sofiapanag/FollowMe-Robot-ESE-519/README.md

# FINAL PROJECT - FOLLOW ME CART GROUP 22

## DEVPOST LINK
https://devpost.com/software/final-project-3opmc1

## Youtube LINK
https://youtu.be/UMGsdQlZP_E

## Compilation
- please find the main.c. Microchip Studio is really bloated hence we placed the whole project in repo. You may need to setup the uart functionalities.
- the controller folder contains necessary files for NodeMCU. You may nead to install the AdaFruit bluefruit library.

### BLUETOOTH

Node MCU - Level Shifter - Arduino

Node MCU SPI Pins
- CLK  - D5
- COPI - D6
- CIPO - D7
- CS   - D8
- IRQ  - D3
- RST  - D2
- Arduino - D1
- Arduino - D0
- Arduino - D4
