sofiapanag/FollowMe-Robot-ESE-519/project_pic.jpeg

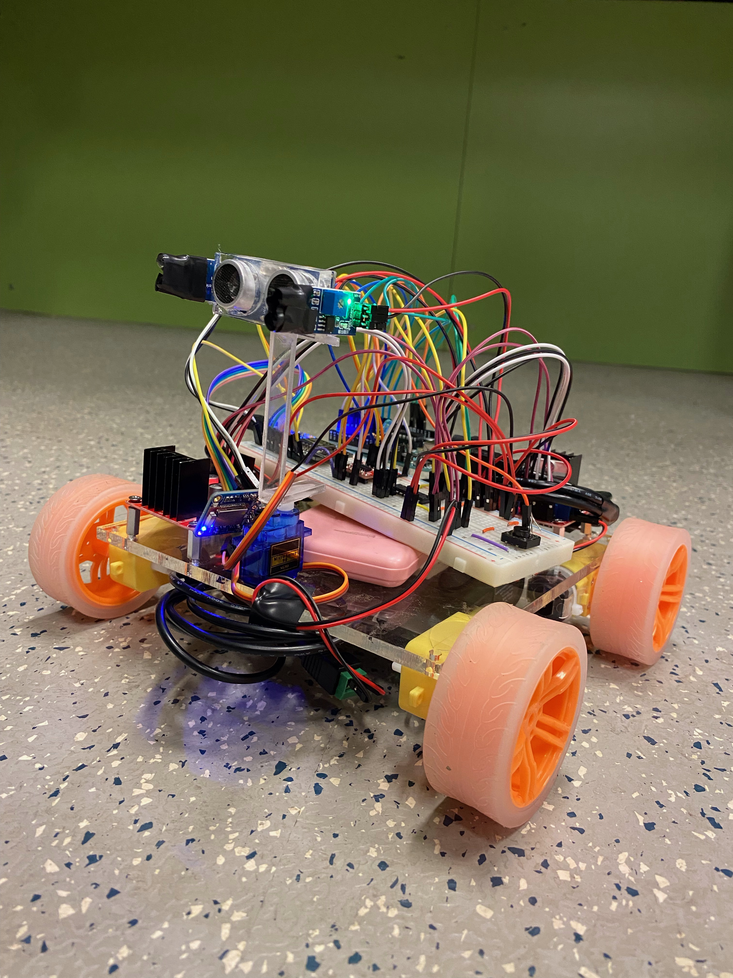
project_pic.jpeg
