sofiapanag/FollowMe-Robot-ESE-519/controller/controller.ino

/*********************************************************************
 This is an example for our nRF51822 based Bluefruit LE modules

 Pick one up today in the adafruit shop!

 Adafruit invests time and resources providing this open source code,
 please support Adafruit and open-source hardware by purchasing
 products from Adafruit!

 MIT license, check LICENSE for more information
 All text above, and the splash screen below must be included in
 any redistribution
*********************************************************************/

#include <string.h>
#include <math.h>
#include <Arduino.h>
#include <SPI.h>
#include "Adafruit_BLE.h"
#include "Adafruit_BluefruitLE_SPI.h"
#include "Adafruit_BluefruitLE_UART.h"

#include "BluefruitConfig.h"


#define UP           1
#define DOWN         3
#define CONNECT         2
// #define RIGHT        4

#if SOFTWARE_SERIAL_AVAILABLE
  #include <SoftwareSerial.h>
#endif

/*=========================================================================
    APPLICATION SETTINGS

    FACTORYRESET_ENABLE       Perform a factory reset when running this sketch
   
                              Enabling this will put your Bluefruit LE module
                              in a 'known good' state and clear any config
                              data set in previous sketches or projects, so
                              running this at least once is a good idea.
   
                              When deploying your project, however, you will
                              want to disable factory reset by setting this
                              value to 0.  If you are making changes to your
                              Bluefruit LE device via AT commands, and those
                              changes aren't persisting across resets, this
                              is the reason why.  Factory reset will erase
                              the non-volatile memory where config data is
                              stored, setting it back to factory default
                              values.
       
                              Some sketches that require you to bond to a
                              central device (HID mouse, keyboard, etc.)
                              won't work at all with this feature enabled
                              since the factory reset will clear all of the
                              bonding data stored on the chip, meaning the
                              central device won't be able to reconnect.
    MINIMUM_FIRMWARE_VERSION  Minimum firmware version to have some new features
    MODE_LED_BEHAVIOUR        LED activity, valid options are
                              "DISABLE" or "MODE" or "BLEUART" or
                              "HWUART"  or "SPI"  or "MANUAL"
    -----------------------------------------------------------------------*/
    #define FACTORYRESET_ENABLE         1
    #define MINIMUM_FIRMWARE_VERSION    "0.6.6"
    #define MODE_LED_BEHAVIOUR          "MODE"
/*=========================================================================*/

// Create the bluefruit object, either software serial...uncomment these lines
/*
SoftwareSerial bluefruitSS = SoftwareSerial(BLUEFRUIT_SWUART_TXD_PIN, BLUEFRUIT_SWUART_RXD_PIN);

Adafruit_BluefruitLE_UART ble(bluefruitSS, BLUEFRUIT_UART_MODE_PIN,
                      BLUEFRUIT_UART_CTS_PIN, BLUEFRUIT_UART_RTS_PIN);
*/

/* ...or hardware serial, which does not need the RTS/CTS pins. Uncomment this line */
// Adafruit_BluefruitLE_UART ble(BLUEFRUIT_HWSERIAL_NAME, BLUEFRUIT_UART_MODE_PIN);

/* ...hardware SPI, using SCK/MOSI/MISO hardware SPI pins and then user selected CS/IRQ/RST */
Adafruit_BluefruitLE_SPI ble(BLUEFRUIT_SPI_CS, BLUEFRUIT_SPI_IRQ, BLUEFRUIT_SPI_RST);

/* ...software SPI, using SCK/MOSI/MISO user-defined SPI pins and then user selected CS/IRQ/RST */
//Adafruit_BluefruitLE_SPI ble(BLUEFRUIT_SPI_SCK, BLUEFRUIT_SPI_MISO,
//                             BLUEFRUIT_SPI_MOSI, BLUEFRUIT_SPI_CS,
//                             BLUEFRUIT_SPI_IRQ, BLUEFRUIT_SPI_RST);


// A small helper
void error(const __FlashStringHelper*err) {
  Serial.println(err);
  while (1);
}

// function prototypes over in packetparser.cpp
uint8_t readPacket(Adafruit_BLE *ble, uint16_t timeout);
float parsefloat(uint8_t *buffer);
void printHex(const uint8_t * data, const uint32_t numBytes);

// the packet buffer
extern uint8_t packetbuffer[];


/**************************************************************************/
/*!
    @brief  Sets up the HW an the BLE module (this function is called
            automatically on startup)
*/
/**************************************************************************/
void setup(void)
{
  while (!Serial);  // required for Flora & Micro
  delay(500);

  Serial.begin(115200);
  Serial.println(F("Adafruit Bluefruit App Controller Example"));
  Serial.println(F("-----------------------------------------"));

  /* Initialise the module */
  Serial.print(F("Initialising the Bluefruit LE module: "));

  if ( !ble.begin(VERBOSE_MODE) )
  {
    error(F("Couldn't find Bluefruit, make sure it's in CoMmanD mode & check wiring?"));
  }
  Serial.println( F("OK!") );

  if ( FACTORYRESET_ENABLE )
  {
    /* Perform a factory reset to make sure everything is in a known state */
    Serial.println(F("Performing a factory reset: "));
    if ( ! ble.factoryReset() ){
      error(F("Couldn't factory reset"));
    }
  }


  /* Disable command echo from Bluefruit */
  ble.echo(false);

  Serial.println("Requesting Bluefruit info:");
  /* Print Bluefruit information */
  ble.info();

  Serial.println(F("Please use Adafruit Bluefruit LE app to connect in Controller mode"));
  Serial.println(F("Then activate/use the sensors, color picker, game controller, etc!"));
  Serial.println();

  ble.verbose(false);  // debug info is a little annoying after this point!

  /* Wait for connection */
  while (! ble.isConnected()) {
      delay(500);
  }

  Serial.println(F("******************************"));

  // LED Activity command is only supported from 0.6.6
  if ( ble.isVersionAtLeast(MINIMUM_FIRMWARE_VERSION) )
  {
    // Change Mode LED Activity
    Serial.println(F("Change LED activity to " MODE_LED_BEHAVIOUR));
    ble.sendCommandCheckOK("AT+HWModeLED=" MODE_LED_BEHAVIOUR);
  }

  // Set Bluefruit to DATA mode
  Serial.println( F("Switching to DATA mode!") );
  ble.setMode(BLUEFRUIT_MODE_DATA);

  Serial.println(F("******************************"));

  digitalWrite(16, HIGH);
  pinMode(16, OUTPUT); // maintain connection
  
  digitalWrite(5, HIGH);
  pinMode(5, OUTPUT); // maintain connection
  
  digitalWrite(2, HIGH);
  pinMode(2, OUTPUT); // maintain connection

}

/**************************************************************************/
/*!
    @brief  Constantly poll for new command or response data
*/
/**************************************************************************/


// float prev_lat, prev_long, prev_alt;
float prev_lat = 0.0;
float prev_lon = 0.0;
float prev_alt = 0.0;

void loop(void)
{

  /* Wait for new data to arrive */
  uint8_t len = readPacket(&ble, BLE_READPACKET_TIMEOUT);
  if (len == 0) return;

  /* Got a packet! */
  // printHex(packetbuffer, len);

  // Color
  if (packetbuffer[1] == 'C') {
    uint8_t red = packetbuffer[2];
    uint8_t green = packetbuffer[3];
    uint8_t blue = packetbuffer[4];
    Serial.print ("RGB #");
    if (red < 0x10) Serial.print("0");
    Serial.print(red, HEX);
    if (green < 0x10) Serial.print("0");
    Serial.print(green, HEX);
    if (blue < 0x10) Serial.print("0");
    Serial.println(blue, HEX);
  }

  // Buttons
  if (packetbuffer[1] == 'B') {
    uint8_t buttnum = packetbuffer[2] - '0';
    boolean pressed = packetbuffer[3] - '0';

    if (buttnum == UP) // forward
    {
      if (pressed) {
        digitalWrite(5, LOW);
        Serial.println("Forward");
      } else {
        digitalWrite(5, HIGH);
      }

    
    } else if (buttnum == DOWN) // back
    {
      if (pressed) {
        digitalWrite(2, LOW);
        Serial.println("Backward");
      } else 
      {
        digitalWrite(2, HIGH);
      }
  
    } else if (buttnum == CONNECT)
    {
      if (pressed)
      {
        digitalWrite(16, !digitalRead(16));
      }

      if (digitalRead(16))
      {
        Serial.println("Not connected");

      } else {
        Serial.println("connected");
      }
      
    }
    
  }

  // GPS Location
  if (packetbuffer[1] == 'L') {
    float lat, lon, alt;
    lat = parsefloat(packetbuffer+2);
    lon = parsefloat(packetbuffer+6);
    alt = parsefloat(packetbuffer+10);


    double lat_1 = lat*(M_PI/180); 
    double lon_1 = lon*(M_PI/180);
    
    double lat_2 = prev_lat*(M_PI/180); 
    double lon_2 = prev_lon*(M_PI/180);

    const double r = 6376.5 *1000;
    
  
    double x_1 = r * sin(lon_1) * cos(lat_1);
    double y_1 = r * sin(lon_1) * sin(lat_1);
    double z_1 = r * cos(lon_1);

    double x_2 = r * sin(lon_2) * cos(lat_2);
    double y_2 = r * sin(lon_2) * sin(lat_2);
    double z_2 = r * cos(lon_2);

    double dist = pow((x_2 - x_1), 2) + pow((y_2 - y_1), 2) + pow((z_2 - z_1), 2);

//    Serial.print("distance: ");
//    Serial.print(dist, 8);
//    Serial.println();

    //if (abs(dist) > 0) {
    // Serial.println("Moving");
//      digitalWrite(16, LOW);
//      delay(300);
//      digitalWrite(16, HIGH);
    //}
      

//    Serial.print("GPS Location\t");
//    Serial.print("Lat: "); Serial.print(lat-prev_lat, 8); // 8 digits of precision!
//    Serial.print('\t');
//    Serial.print("Lon: "); Serial.print(lon-prev_lon, 8); // 8 digits of precision!
//    Serial.print('\t');
//    Serial.print(alt-prev_alt, 8); Serial.println(" meters");
    prev_lon = lon;
    prev_lat = lat;
    prev_alt = alt;
   
  }

  // Accelerometer
  if (packetbuffer[1] == 'A') {
    float x, y, z;
    x = parsefloat(packetbuffer+2);
    y = parsefloat(packetbuffer+6);
    z = parsefloat(packetbuffer+10);
//    
//    Serial.print("Accel\t");
//    Serial.print(x); Serial.print('\t');
//    Serial.print(y); Serial.print('\t');
//    Serial.print(z); Serial.println();
    
  }

  // Magnetometer
  if (packetbuffer[1] == 'M') {
    float x, y, z;
    x = parsefloat(packetbuffer+2);
    y = parsefloat(packetbuffer+6);
    z = parsefloat(packetbuffer+10);
//    Serial.print("Mag\t");
//    Serial.print(x); Serial.print('\t');
//    Serial.print(y); Serial.print('\t');
//    Serial.print(z); Serial.println();
  }

  // Gyroscope
  if (packetbuffer[1] == 'G') {
    float x, y, z;
    x = parsefloat(packetbuffer+2);
    y = parsefloat(packetbuffer+6);
    z = parsefloat(packetbuffer+10);
//    Serial.print("Gyro\t");
//    Serial.print(x); Serial.print('\t');
//    Serial.print(y); Serial.print('\t');
//    Serial.print(z); Serial.println();
  }

  // Quaternions
  if (packetbuffer[1] == 'Q') {
    float x, y, z, w;
    x = parsefloat(packetbuffer+2);
    y = parsefloat(packetbuffer+6);
    z = parsefloat(packetbuffer+10);
    w = parsefloat(packetbuffer+14);
//    Serial.print("Quat\t");
//    Serial.print(x); Serial.print('\t');
//    Serial.print(y); Serial.print('\t');
//    Serial.print(z); Serial.print('\t');
//    Serial.print(w); Serial.println();
  }
}
