sofiapanag/FollowMe-Robot-ESE-519/Follow_Me/Follow_Me/myuart.h

//
// Created by Sofia Panagopoulou on 13/10/21.
//

#include <avr/io.h>
#include <stdio.h>

#define F_CPU 16000000UL
#define BAUD_RATE 9600
#define BAUD_PRESCALER ((F_CPU/(16UL*BAUD_RATE)-1))

void UART_initialize () {
    /*Set baud rate */
    UBRR0H = (unsigned char)(BAUD_PRESCALER>>8);
    UBRR0L = (unsigned char)BAUD_PRESCALER;
    //Enable receiver and transmitter
    UCSR0B = (1<<RXEN0)|(1<<TXEN0);
    /* Set frame format: 2 stop bits, 8 data bits */
    UCSR0C = (1<<UCSZ01) | (1<<UCSZ00); // 8 data bits
    UCSR0C |= (1<<USBS0); // 2 stop bits
}

void UART_send (unsigned char data) {
    // Wait for empty transmit buffer
    while(!(UCSR0A & (1<<UDRE0)));
    // Put data into buffer and send data
    UDR0 = data;                  // put data into buffer and send data
}

void UART_putstring (char* StringPtr) {
    while(*StringPtr != 0x00) {
        UART_send(*StringPtr);
        StringPtr++;
    }
}
