sofiapanag/FollowMe-Robot-ESE-519/(commit log)

2021-11-21 added arduino code
2021-11-28 uploading bloated Microchip folder. Implemented PWM for TIMER2 and TIMER0
2021-12-02 modified timer0 and timer1 pwm to phase correct
    [main.c, main.cpp]
