sofiapanag/FollowMe-Robot-ESE-519/image1.jpeg

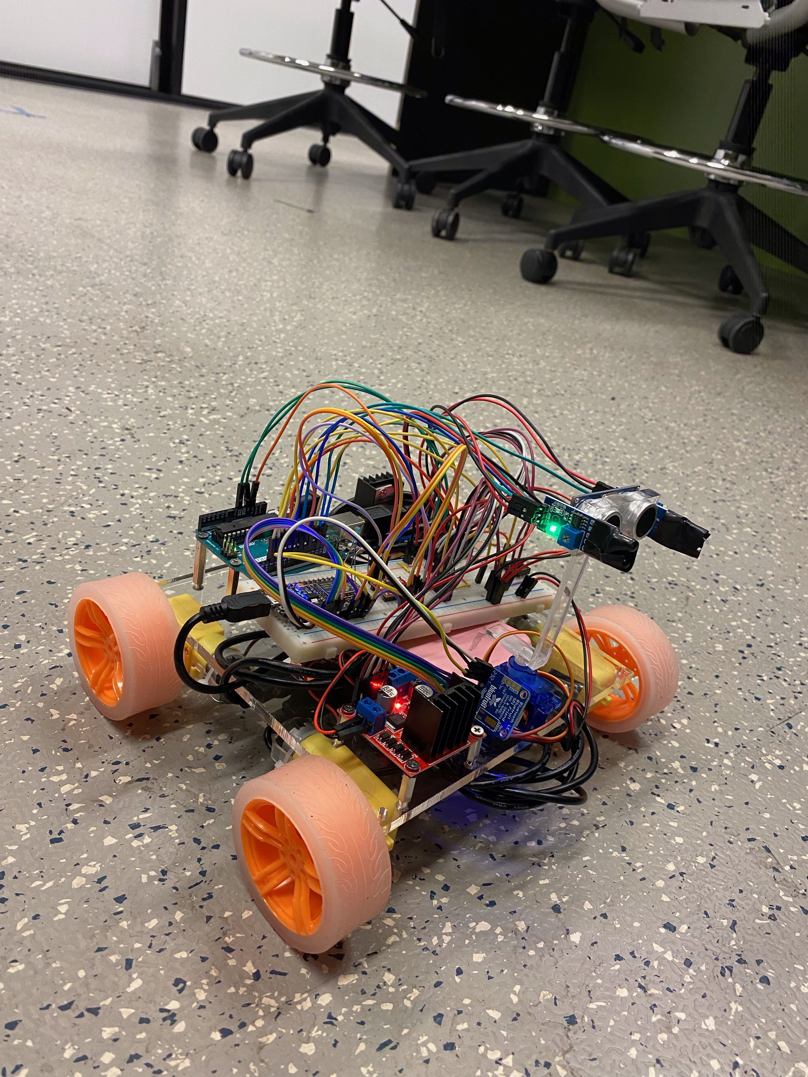
image1.jpeg
