sofiapanag/FollowMe-Robot-ESE-519/image4.jpeg

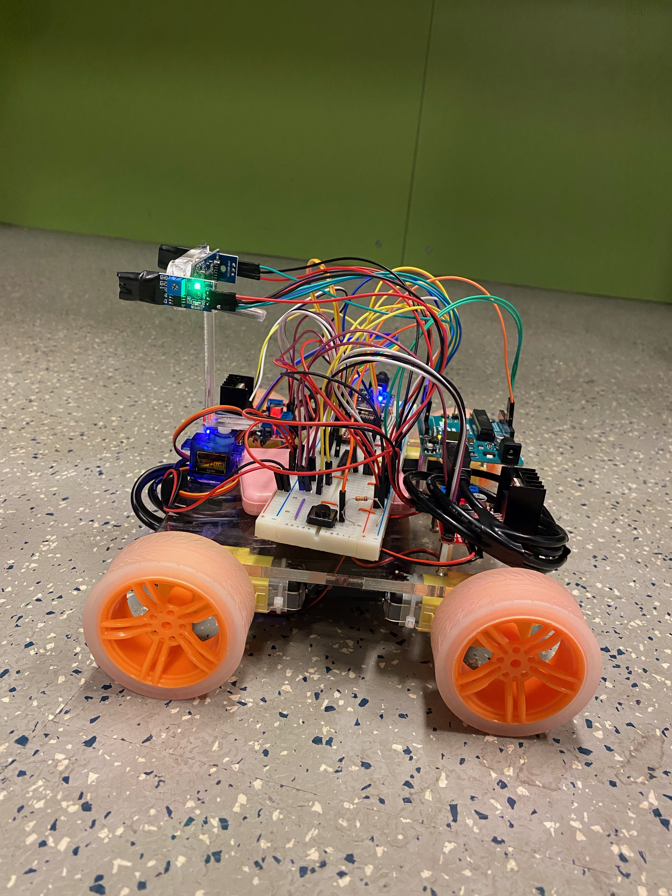
image4.jpeg
