sofiapanag/FollowMe-Robot-ESE-519/image2.jpeg

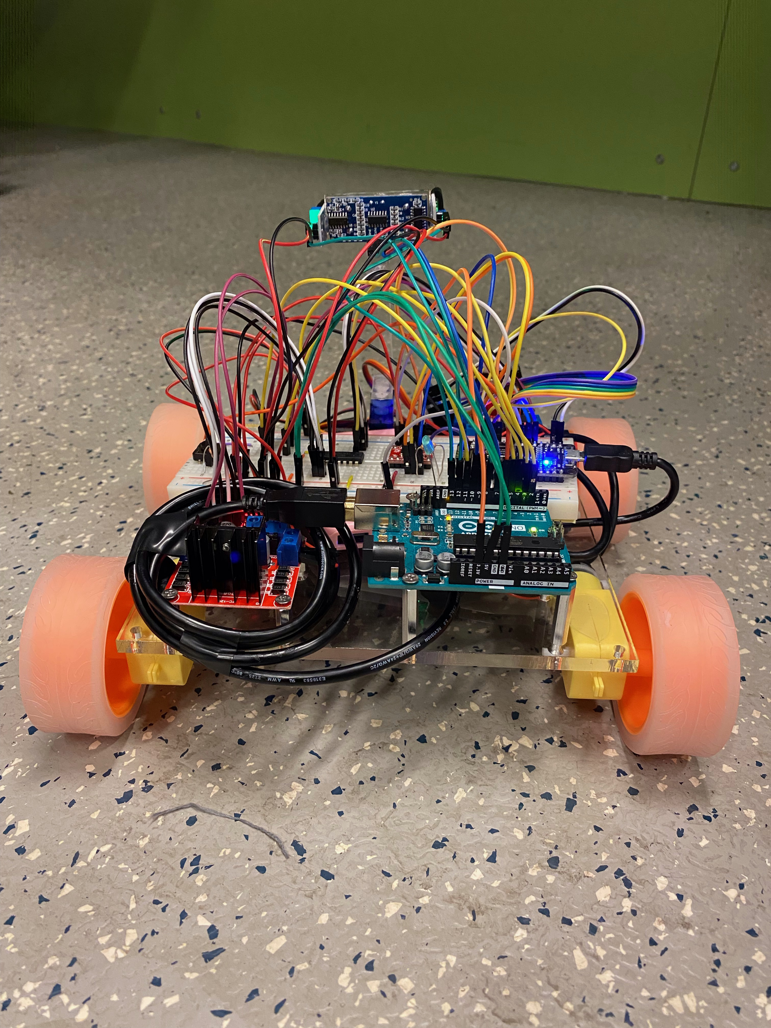
image2.jpeg
